ttran244-uic/Senior-Design-2025-Intercom/ECE 397 Ordering Form_02-03-25.xlsx

Team Name: Hertz So Good (H.S.G.) ~ Team 16 |  |  |  |  | ECE Project Mentor (Name and Email): | Dr. Ryan Corey, corey1@uic.edu
Team Representative email | mloera3@uic.edu |  |  |  | ECE 397 Professor (Name and Email): | Dr. Renata Revelo Alonso, revelo@uic.edu
Preferred Delivery date: | 2025-02-07
Name of Part | Part Number | Quantity | Unit Cost | Total Price | Website Link
Audio processor | ADAU1701JSTZ | 2 | 14.68 | 29.36 | https://www.digikey.com/en/products/detail/analog-devices-inc/ADAU1701JSTZ/1246074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
Power Path Controller | LTC4412HVIS6#TRPBFDKR-ND - Digi-Reel® | 1 | 7.11 | 7.11 | https://www.digikey.com/en/products/detail/analog-devices-inc/LTC4412HVIS6-TRPBF/1621436
Antenna w/ transceiver | CC1101 Wireless Module with SMA Antenna Wireless Transceiver Module x2 | 1 | 18.99 | 18.99 | https://www.amazon.com/DWEII-Wireless-Antenna-Transceiver-Arduino/dp/B0CSYX1454
Speaker amplifier | PAM8403 Mini 2 Channel 3W Stereo Class D Audio Power Amplifier Module Board (2-pack) | 1 | 5.49 | 5.49 | https://www.amazon.com/PAM8403-Channel-Amplifier-Envistia-Mall/dp/B07N12VPTS
Battery | BL3000F9031781S1PCNC | 2 | 19.03 | 38.06 | https://www.digikey.com/en/products/detail/globtek-inc/BL3000F9031781S1PCNC/14829887
Charger | Lithium Battery Charger Module Charging | 1 | 5.99 | 5.99 | https://www.amazon.com/HiLetgo-Lithium-Charging-Protection-Functions/dp/B07PKND8KG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
 | USB C Charger Block 2-Pack | 1 | 5.99 | 5.99 | https://www.amazon.com/Charger-2-Pack-Charging-Adapter-Samsung/dp/B0D8JDSYZB?s=electronics
Microphone | 6 Pieces Electret Microphone Amplifier Module MAX4466 | 1 | 9.99 | 9.99 | https://www.amazon.com/Electret-Microphone-Amplifier-Adjustable-Breakout/dp/B08N4FNFTR
Microphone | TA312S | 1 | 25.99 | 25.99 | https://www.amazon.com/Behringer-Dynamic-Microphone-TA-312S/dp/B083FJJPNH
XLR Connector | E3FRA | 1 | 8.23 | 8.23 | https://www.digikey.com/en/products/detail/switchcraft-inc/E3FRA/1289115
Buck/boost converter | LTC1475CS8-3.3#PBF | 2 | 12.82 | 25.64 | https://www.digikey.com/en/products/detail/analog-devices-inc/LTC1475CS8-3.3-PBF/963201?gQT=1
Volume dial | Anodized Aluminum Machined Knob - Black - 20mm Diameter | 4 | 2.95 | 11.8 | https://www.adafruit.com/product/5527
Push-button (blue) | Rugged Metal On/Off Switch with Blue LED Ring - 16mm Blue On/Off | 2 | 4.95 | 9.9 | https://www.adafruit.com/product/915
Push-button (green) | Rugged Metal On/Off Switch with Green LED Ring - 16mm Green On/Off | 2 | 4.95 | 9.9 | https://www.adafruit.com/product/482
Push-button (white) | Rugged Metal On/Off Switch with White LED Ring - 16mm White On/Off | 2 | 4.95 | 9.9 | https://www.adafruit.com/product/917
Push-button (red) | Rugged Metal On/Off Switch with Green LED Ring - 16mm Red On/Off | 2 | 4.95 | 9.9 | https://www.adafruit.com/product/916
USB-C Breakout Board | 1568-1958-ND | 2 | 4.95 | 9.9 | BOB-15100 SparkFun Electronics | Prototyping, Fabrication Products | DigiKey (https://www.digikey.com/en/products/detail/sparkfun-electronics/BOB-15100/9770720)
Boost Converter | 5V-32V Input to 6V-48V Output Adjustable Boost Step Up XL6009 DC-DC Converter | 1 | 6.49 | 6.49 | Amazon.com: 5V-32V Input to 6V-48V Output Adjustable Boost Step Up XL6009 DC-DC Converter : Electronics (https://www.amazon.com/3V-32V-5V-48V-Output-Adjustable-Converter/dp/B01MS3IAVL)
Headphone Jack | 54-00174 | 1 | 0.66 | 0.66 | https://www.digikey.com/en/products/detail/tensility-international-corp/54-00174/12140150
 | Potentiometer - 10k-ohm | 3 | 1.25 | 3.75 | https://www.adafruit.com/product/4133
 |  |  |  | 0
 |  |  |  | 0
 |  |  |  | 0
 |  |  |  | 0
 |  |  |  | 0
 |  |  | total | 253.04
 |  |  |  | 0
 |  |  |  | 0
 |  |  |  | 0
 |  |  |  | 0
 |  |  |  | 0
 |  |  |  | 0
 |  |  |  | 0
 |  |  |  | 0
 |  |  |  | 0
 |  |  |  | 0
 |  |  |  | 0
 |  |  |  | 0
 |  |  |  | 0
 |  |  |  | 0
 |  |  |  | 0
 |  |  |  | 0
 |  |  |  | 0
 |  |  |  | 0
 |  |  |  | 0
 |  |  |  | 0
