ttran244-uic/Senior-Design-2025-Intercom/ECE 397 Ordering Form_02-04-25.xlsx

Team Name: Hertz So Good (H.S.G.) ~ Team 16 |  |  |  |  | ECE Project Mentor (Name and Email): | Dr. Ryan Corey, corey1@uic.edu
Team Representative email | mloera3@uic.edu |  |  |  | ECE 397 Professor (Name and Email): | Dr. Renata Revelo Alonso, revelo@uic.edu
Preferred Delivery date: | 2025-02-10
Name of Part | Part Number | Quantity | Unit Cost | Total Price | Website Link
Antenna w/ transceiver | CC1101 Wireless Module with SMA Antenna Wireless Transceiver Module | 1 | 18.99 | 18.99 | https://www.amazon.com/CC1101-Multi-Frequency-Transceiver-Modules-2PCS/dp/B0DBSYK911
Speaker amplifier | NOYITO PAM8406 Digital Amplifier Board 5W 5W Dual Channel Stereo Audio Module (2 pack) | 1 | 5.99 | 5.99 | https://www.amazon.com/NOYITO-PAM8406-Digital-Amplifier-Dual-Channel/dp/B07FZYK7HG
 |  |  |  | 0
 |  |  |  | 0
 |  |  | 24.98 | 0
 |  |  |  | 0
 |  |  |  | 0
 |  |  |  | 0
 |  |  |  | 0
 |  |  |  | 0
 |  |  |  | 0
 |  |  |  | 0
 |  |  |  | 0
 |  |  |  | 0
 |  |  |  | 0
 |  |  |  | 0
 |  |  |  | 0
 |  |  |  | 0
 |  |  |  | 0
 |  |  |  | 0
 |  |  |  | 0
 |  |  |  | 0
 |  |  |  | 0
 |  |  |  | 0
 |  |  |  | 0
 |  |  |  | 0
 |  |  |  | 0
 |  |  |  | 0
