ttran244-uic/Senior-Design-2025-Intercom/ECE 397 Ordering Form_02-18-25.xlsx

Team Name: Hertz So Good (H.S.G.) ~ Team 16 |  |  |  |  | ECE Project Mentor (Name and Email): | Dr. Ryan Corey, corey1@uic.edu
Team Representative email | nlara6@uic.edu |  |  |  | ECE 397 Professor (Name and Email): | Dr. Renata Revelo Alonso, revelo@uic.edu
Preferred Delivery date: | 2025-02-24
Name of Part | Part Number | Quantity | Unit Cost | Total Price | Website Link
3.5mm Headphone Jack with Switch | SJ-43515RS-SMT-TR | 2 | 0.93 | 1.86 | https://www.digikey.com/en/products/detail/same-sky-formerly-cui-devices/SJ-43515RS-SMT-TR/669722
Stereo Audio Amplifier | PAM8406DR | 2 | 1.34 | 2.68 | https://www.digikey.com/en/products/detail/diodes-incorporated/PAM8406DR/4033289
Ferrite Beads | MPZ1608S221ATA00 | 10 | 0.1 | 1 | https://www.digikey.com/en/products/detail/tdk-corporation/MPZ1608S221ATA00/571872
Headphone Amplifier | MAX97220 | 1 | 3.15 | 3.15 | https://www.digikey.com/en/products/detail/analog-devices-inc-maxim-integrated/MAX97220AETE-T/2744332
