ttran244-uic/Senior-Design-2025-Intercom/ECE 397 Ordering Form_02-25-25 (Dr. Corey).xlsx

Team Name: Hertz So Good (H.S.G.) ~ Team 16 |  |  |  |  | ECE Project Mentor (Name and Email): | Dr. Ryan Corey, corey1@uic.edu
Team Representative email | nlara6@uic.edu |  |  |  | ECE 397 Professor (Name and Email): | Dr. Renata Revelo Alonso, revelo@uic.edu
Preferred Delivery date: | 2025-02-28
Name of Part | Part Number | Quantity | Unit Cost | Total Price | Website Link
Arduino Nano ESP32 | Arduino Nano ESP32 with headers [ABX00083] ESP32-S3, USB-C, Wi-Fi, Bluetooth, HID Support, MicroPython Compatible | 1 | $23.00 | $23.00 | Amazon Link (https://www.amazon.com/Arduino-ABX00083-Bluetooth-MicroPython-Compatible/dp/B0C947BHK5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)
USB-C to USB-C Data Cables | 1FT USB C to USB C Cable 100W 2 Packs, Short USB C 3.1 Fast Charging PD Cord, 10Gbps High Speed Data, 4K@60Hz Video Output Compatible for iPhone 15/15 Plus/15 Pro Max, MacBook, Monitor, SSD | 1 | $8.99 | $8.99 | Amazon Link (https://www.amazon.com/SUMPK-Charging-MacBook-Samsung-Display/dp/B09Z6J21LY?sp_csd=d2lkZ2V0TmFtZT1zcF9hdGY)
EEPROM | 24AA256-I/ST | 2 | $1.09 | $2.18 | DigiKey Link (https://www.digikey.com/en/products/detail/microchip-technology/24AA256-I-ST/442755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)
Transceiver | HiLetgo 2pcs NRF24L01+PA+LNA Wireless Transceiver RF Transceiver Module with SMA Antenna 2.4G 1100m | 1 | $8.49 | $8.49 | Amazon Link (https://www.amazon.com/HiLetgo%C2%AE-NRF24L01-Wireless-Transceiver-Compatible/dp/B00WG9HO6Q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)
