ttran244-uic/Senior-Design-2025-Intercom/CAD Files/ECE 397_Secondary Casing.stl

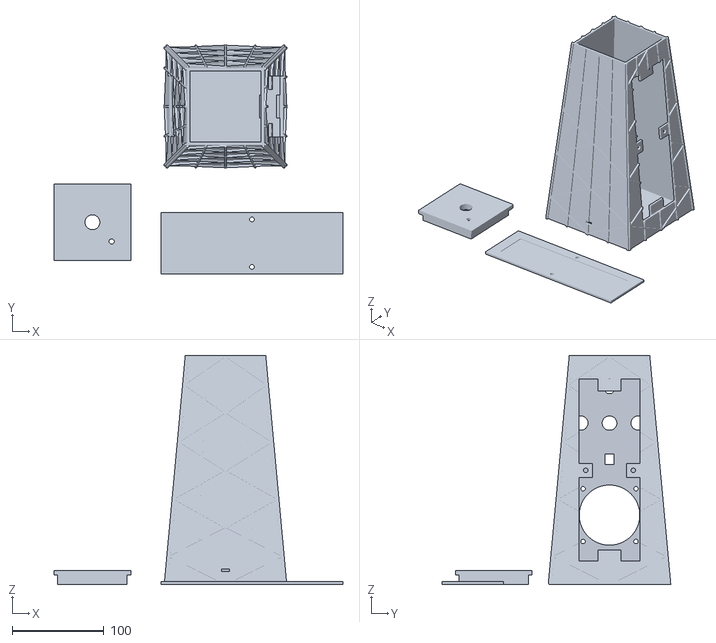
[picture p1: CAD file, 2025-06-10]
CAD Files/ECE 397_Secondary Casing.stl
315.9 x 249.9 x 250.4
