ttran244-uic/Senior-Design-2025-Intercom/CAD Files/ECE 397_Primary Casing (Lid).stl

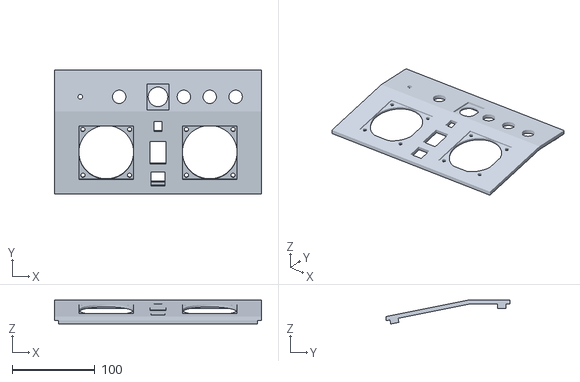
[picture p2: CAD file, 2025-06-10]
CAD Files/ECE 397_Primary Casing (Lid).stl
250.0 x 150.0 x 28.9
