ttran244-uic/Senior-Design-2025-Intercom/Schematics/Primary Audio Amplifier Module.pdf

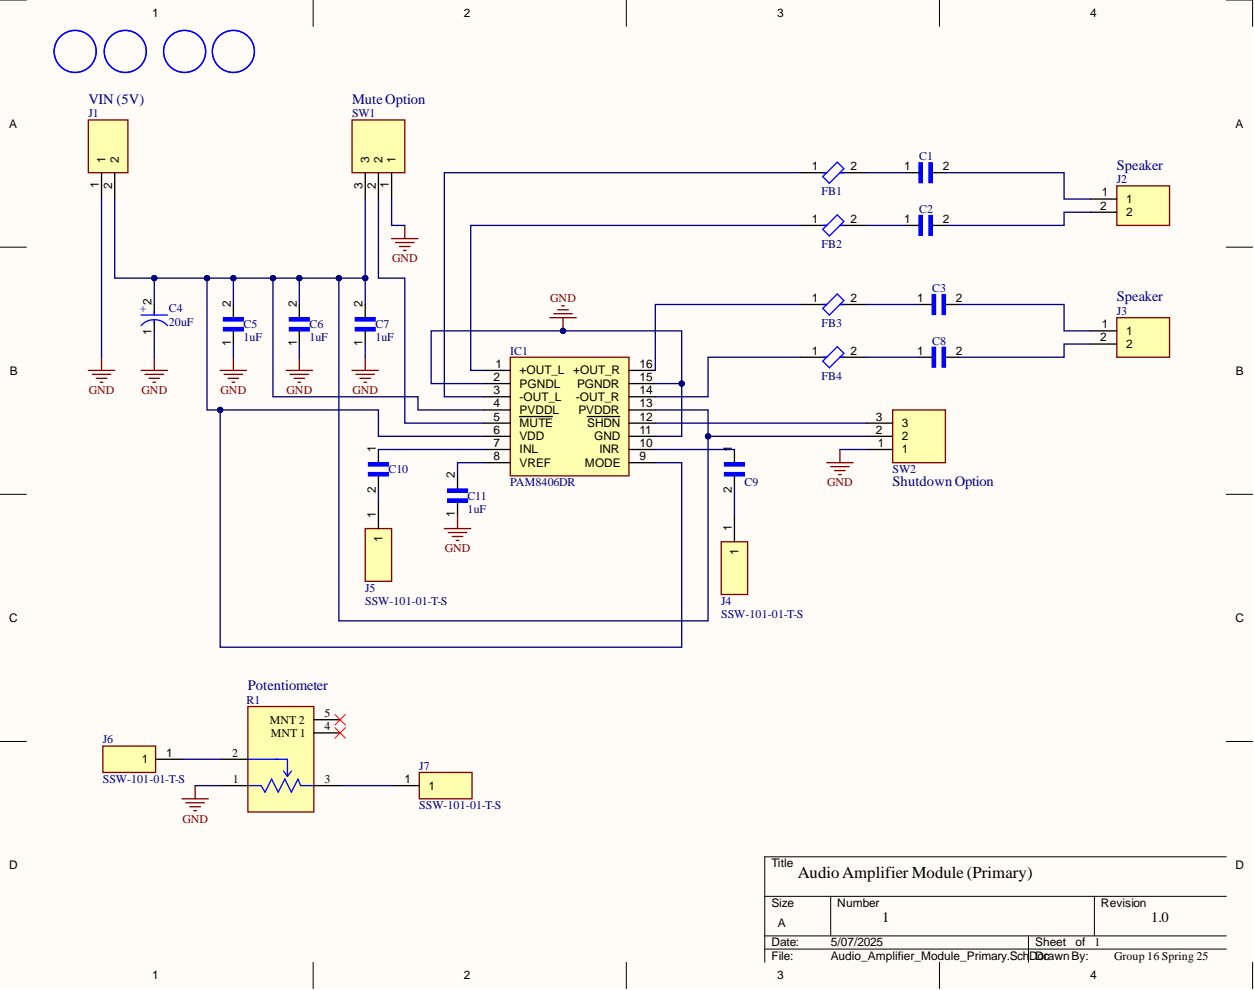
[picture p4: page 1]

GND

PGNDL 2 PGNDR -OUT_R | 15
-OUT_L 3 | 14
PVDDL 4 PVDDR | 13
MUTE 5 SHDN INR | 12

INL 7 | 10

Title
Audio Amplifier Module (Primary)
