ttran244-uic/Senior-Design-2025-Intercom/Schematics/Primary Device Schematic.pdf

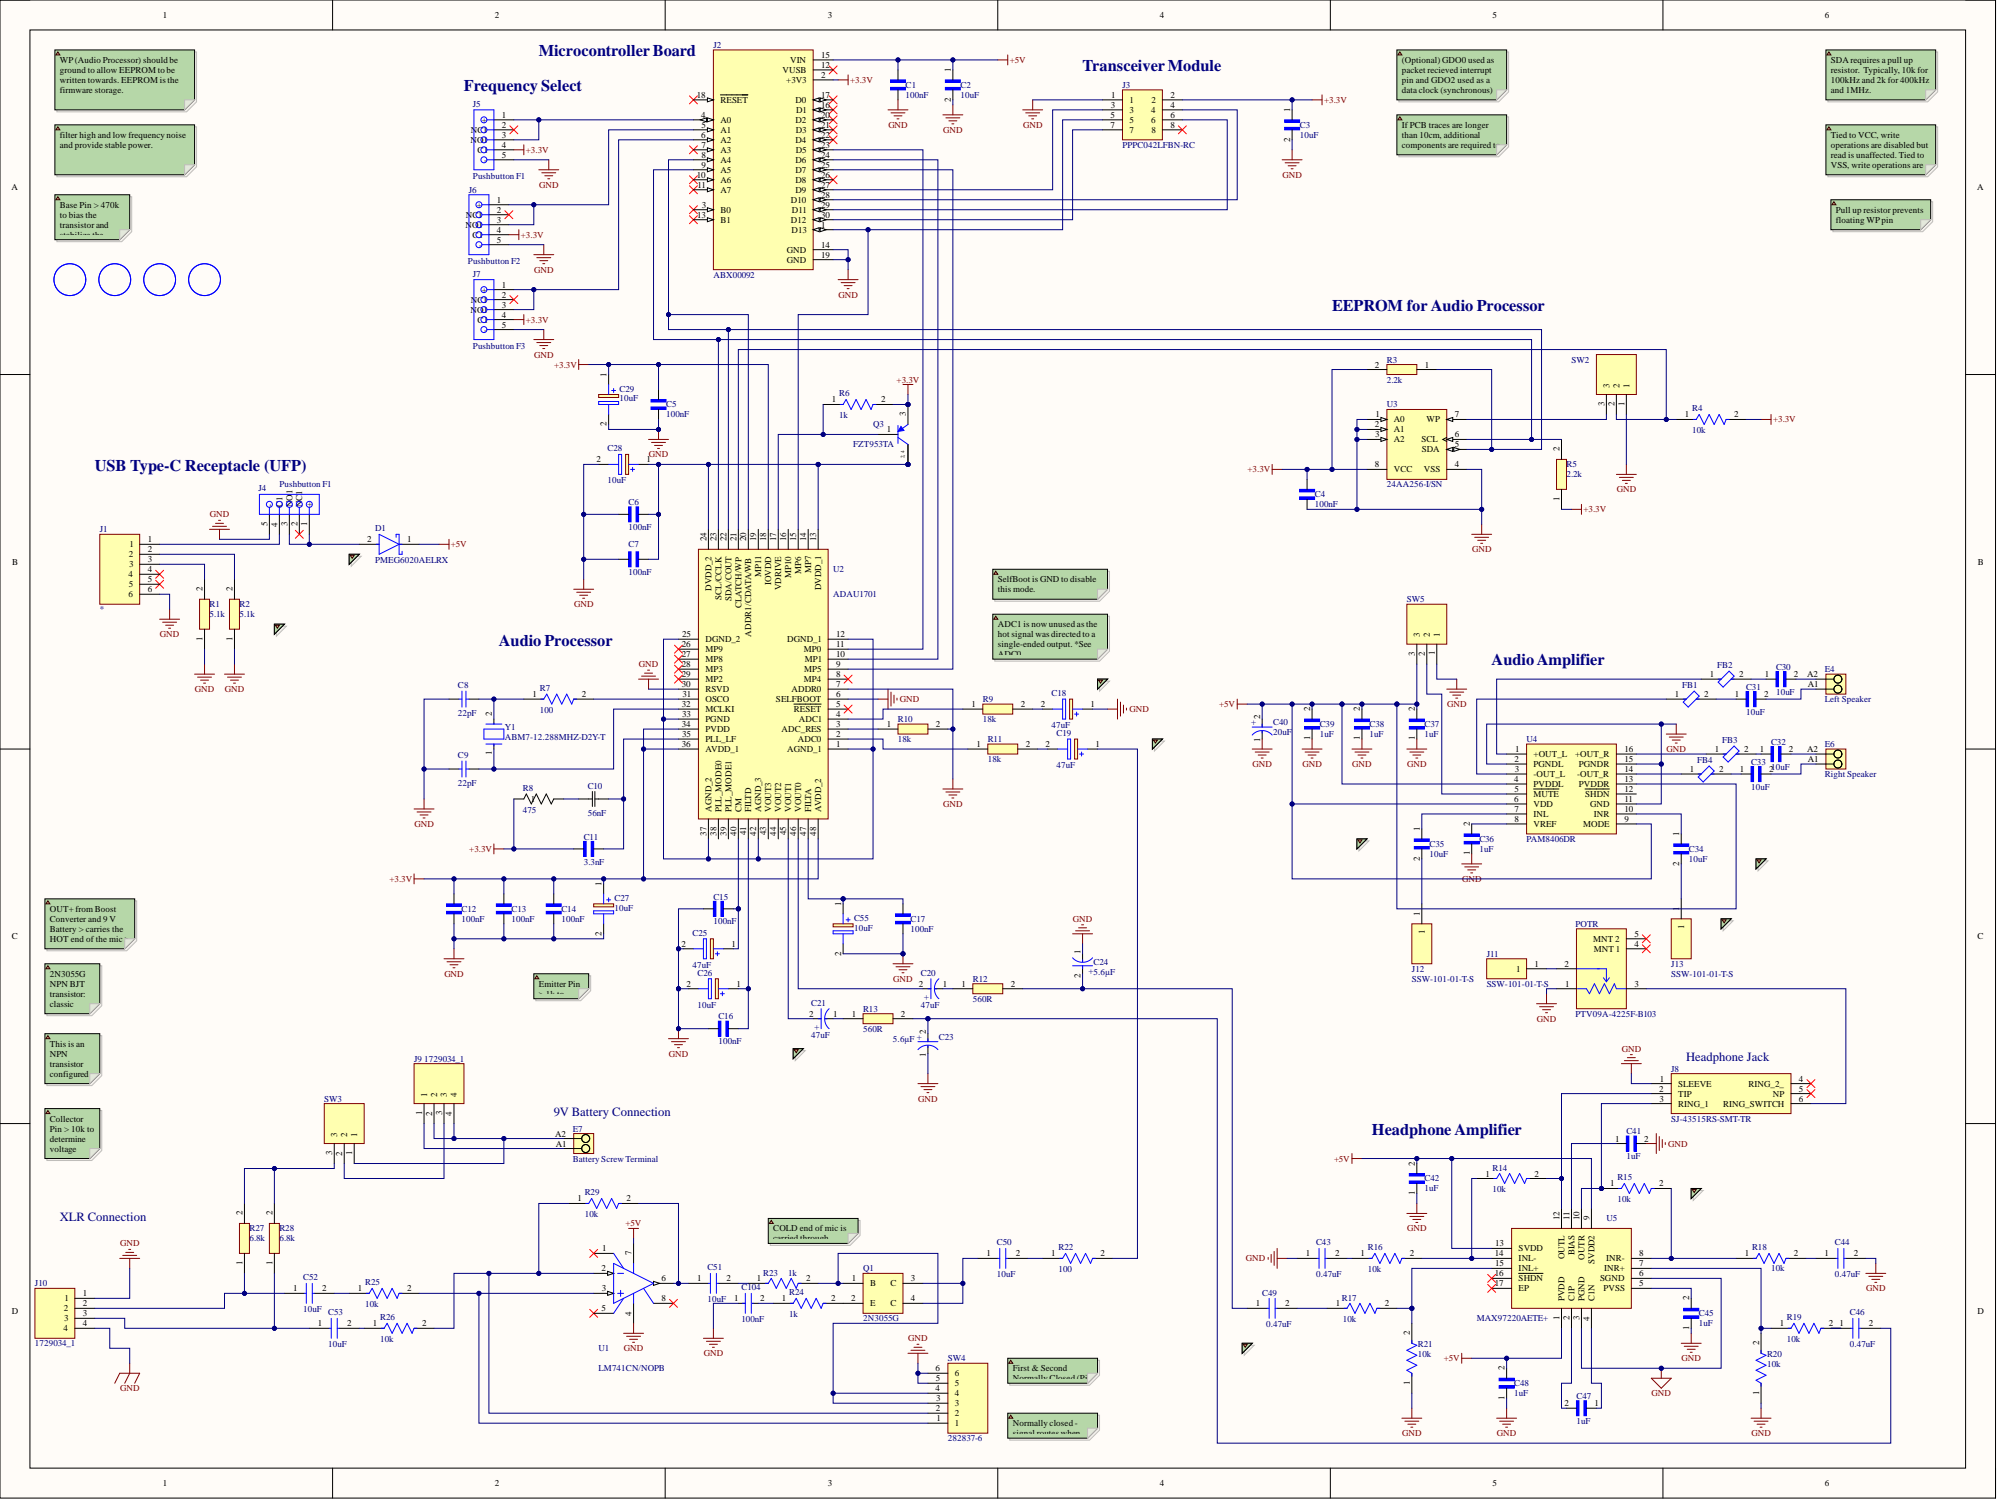
[picture p5: page 1]

WP (Audio Processor) should be
ground to allow EEPROM to be
written towards. EEPROM is the
firmware storage.

(Optional) GDO0 used as
packet recieved interrupt
pin and GDO2 used as a
data clock (synchronous)

SDA requires a pull up
resistor. Typically, 10k for
100kHz and 2k for 400kHz
and 1MHz.

If PCB traces are longer
than 10cm, additional
components are required to

filter high and low frequency noise
and provide stable power.

Tied to VCC, write
operations are disabled but
read is unaffected. Tied to
VSS, write operations are

Pull up resistor prevents
floating WP pin

EEPROM for Audio Processor

USB Type-C Receptacle (UFP)

DVDD_1 13 MP7 14 MP6 15 MP10 16 VDRIVE 17 IOVDD 18 MP11 19 ADDR1/CDATA/WB 20 CLATCH/WP 21 SDA/COUT 22 SCL/CCLK 23 DVDD_2 24 AVDD_1 36 PLL_LF 35 PVDD 34 PGND 33 MCLKI 32 OSCO 31 RSVD 30 MP2 29 MP3 28 MP8 27 MP9 26 DGND_2 25

SelfBoot is GND to disable
this mode.

ADC1 is now unused as the
hot signal was directed to a
single-ended output. *See
ADC0

-OUT_L 3 -OUT_R | 14
PVDDL 4 PVDDR | 13

OUT+ from Boost
Converter and 9 V
Battery > carries the
HOT end of the mic >

COLD end of mic is
carried through
