ttran244-uic/Senior-Design-2025-Intercom/Schematics/Audio Processor Module Schematic.pdf

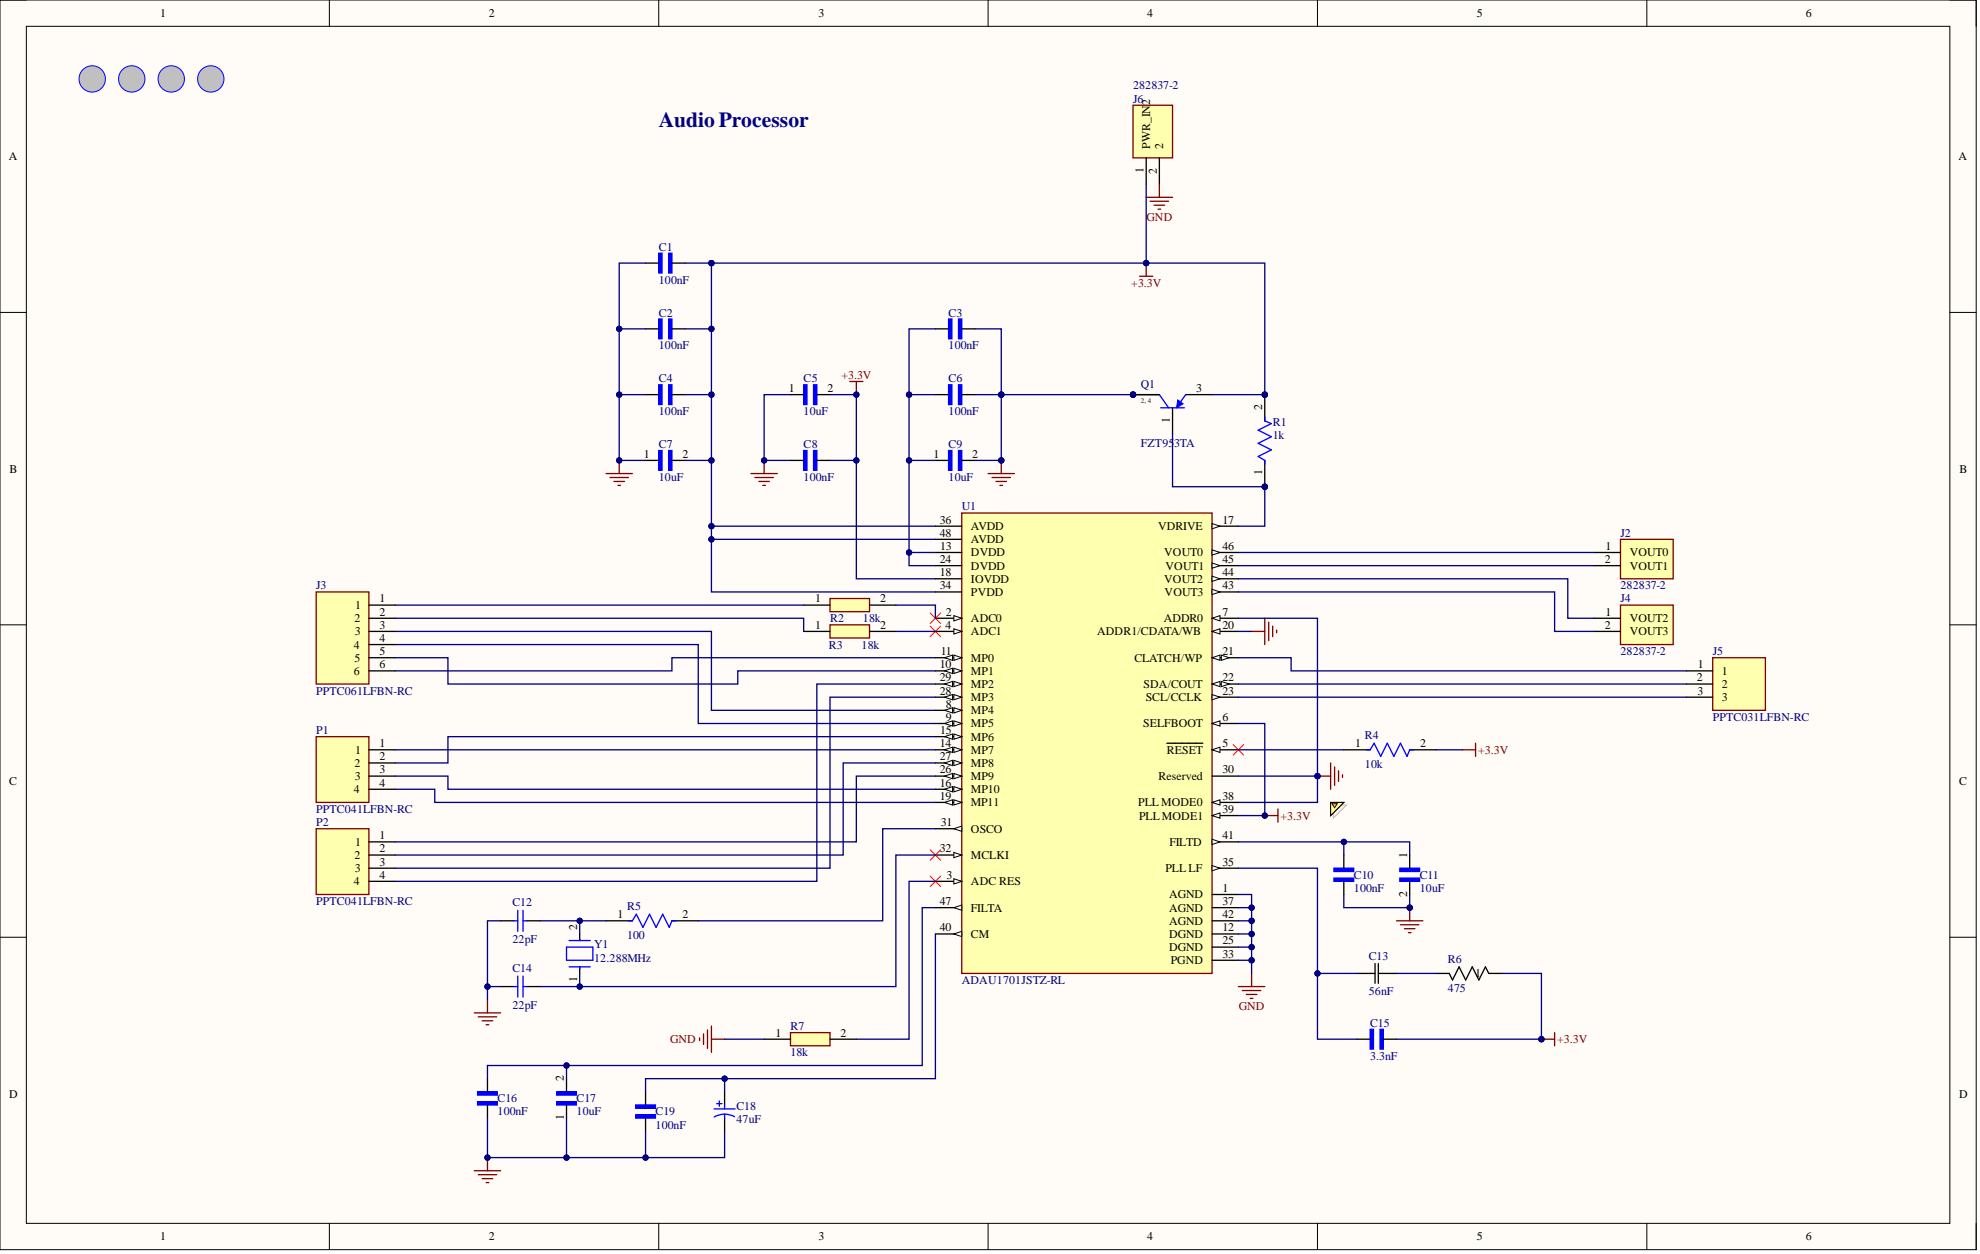
[picture p6: page 1]

AVDD 48

DVDD 24 | VOUT1 2

MP1 10 | 1 1
MP2 29 | 2 2
MP3 28 | 3 3
MP4 8
MP5 9
MP6 15
