ttran244-uic/Senior-Design-2025-Intercom/Schematics/EEPROM Module Schematic.pdf

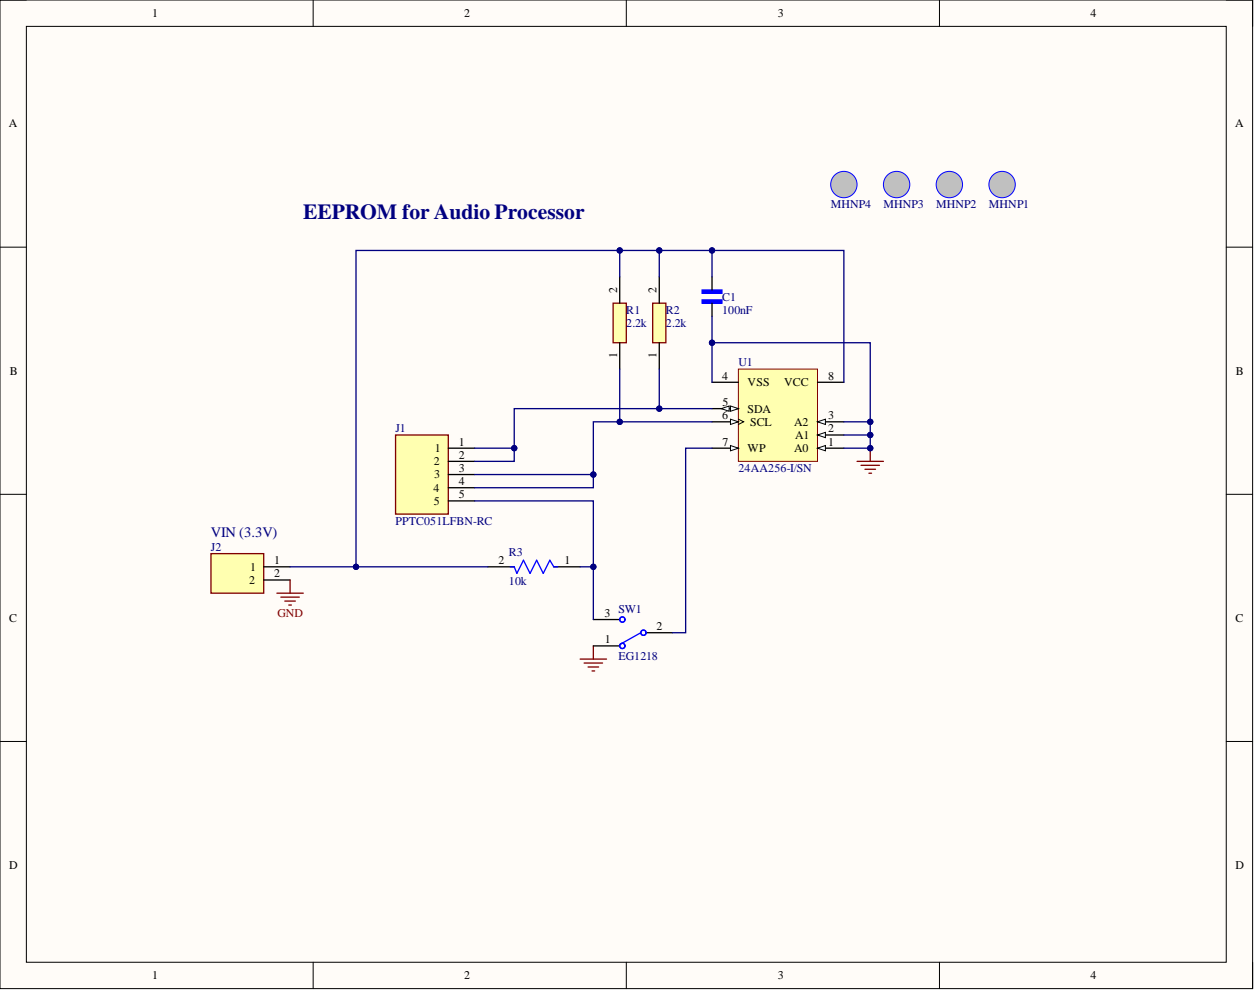
[picture p7: page 1]

EEPROM for Audio Processor
