ttran244-uic/Senior-Design-2025-Intercom/Schematics/Gooseneck Microphone Module.pdf

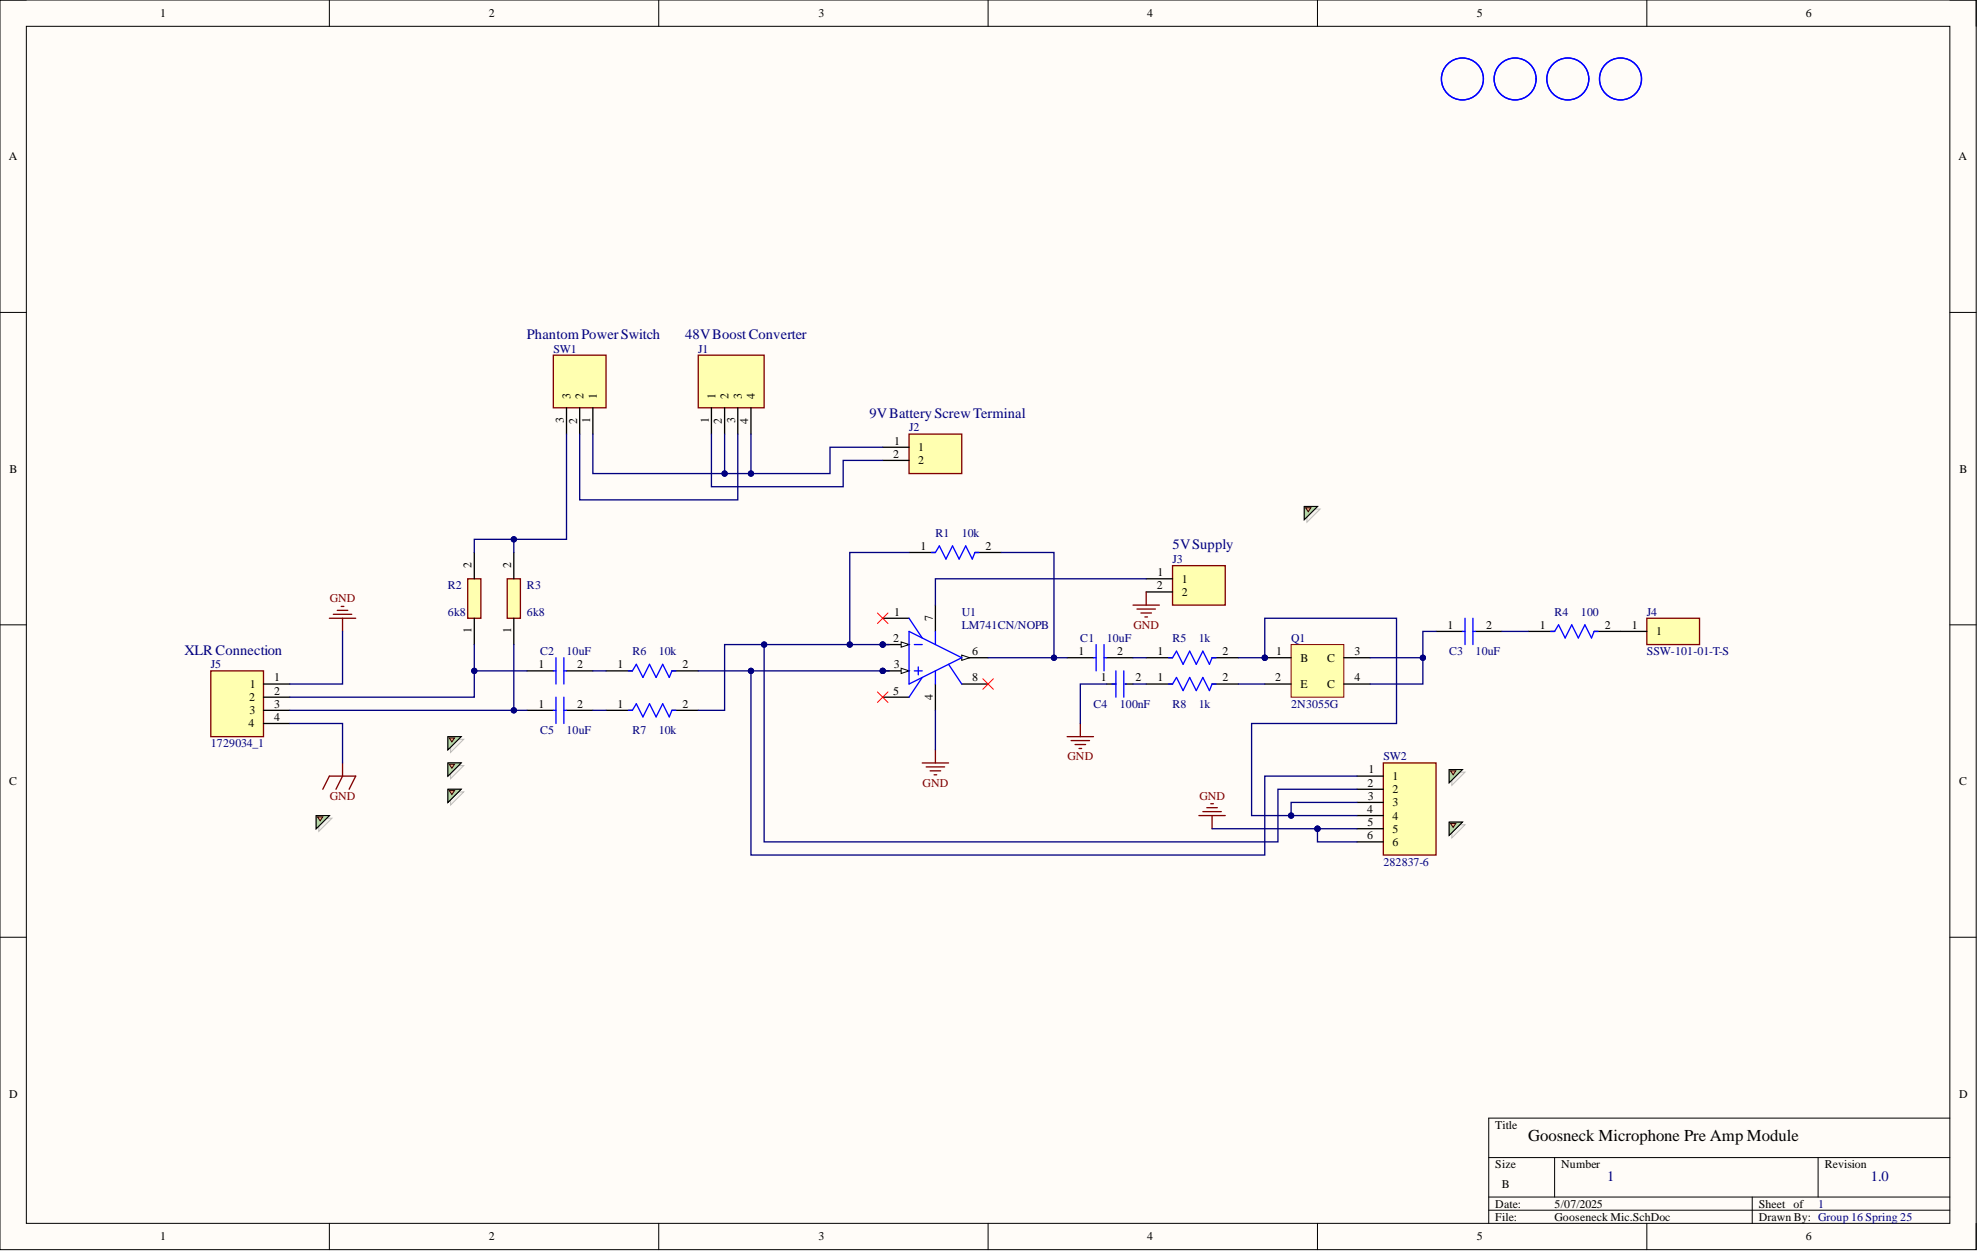
[picture p8: page 1]

Title
Goosneck Microphone Pre Amp Module
