ttran244-uic/Senior-Design-2025-Intercom/Schematics/Headphone Amplifier Module.pdf

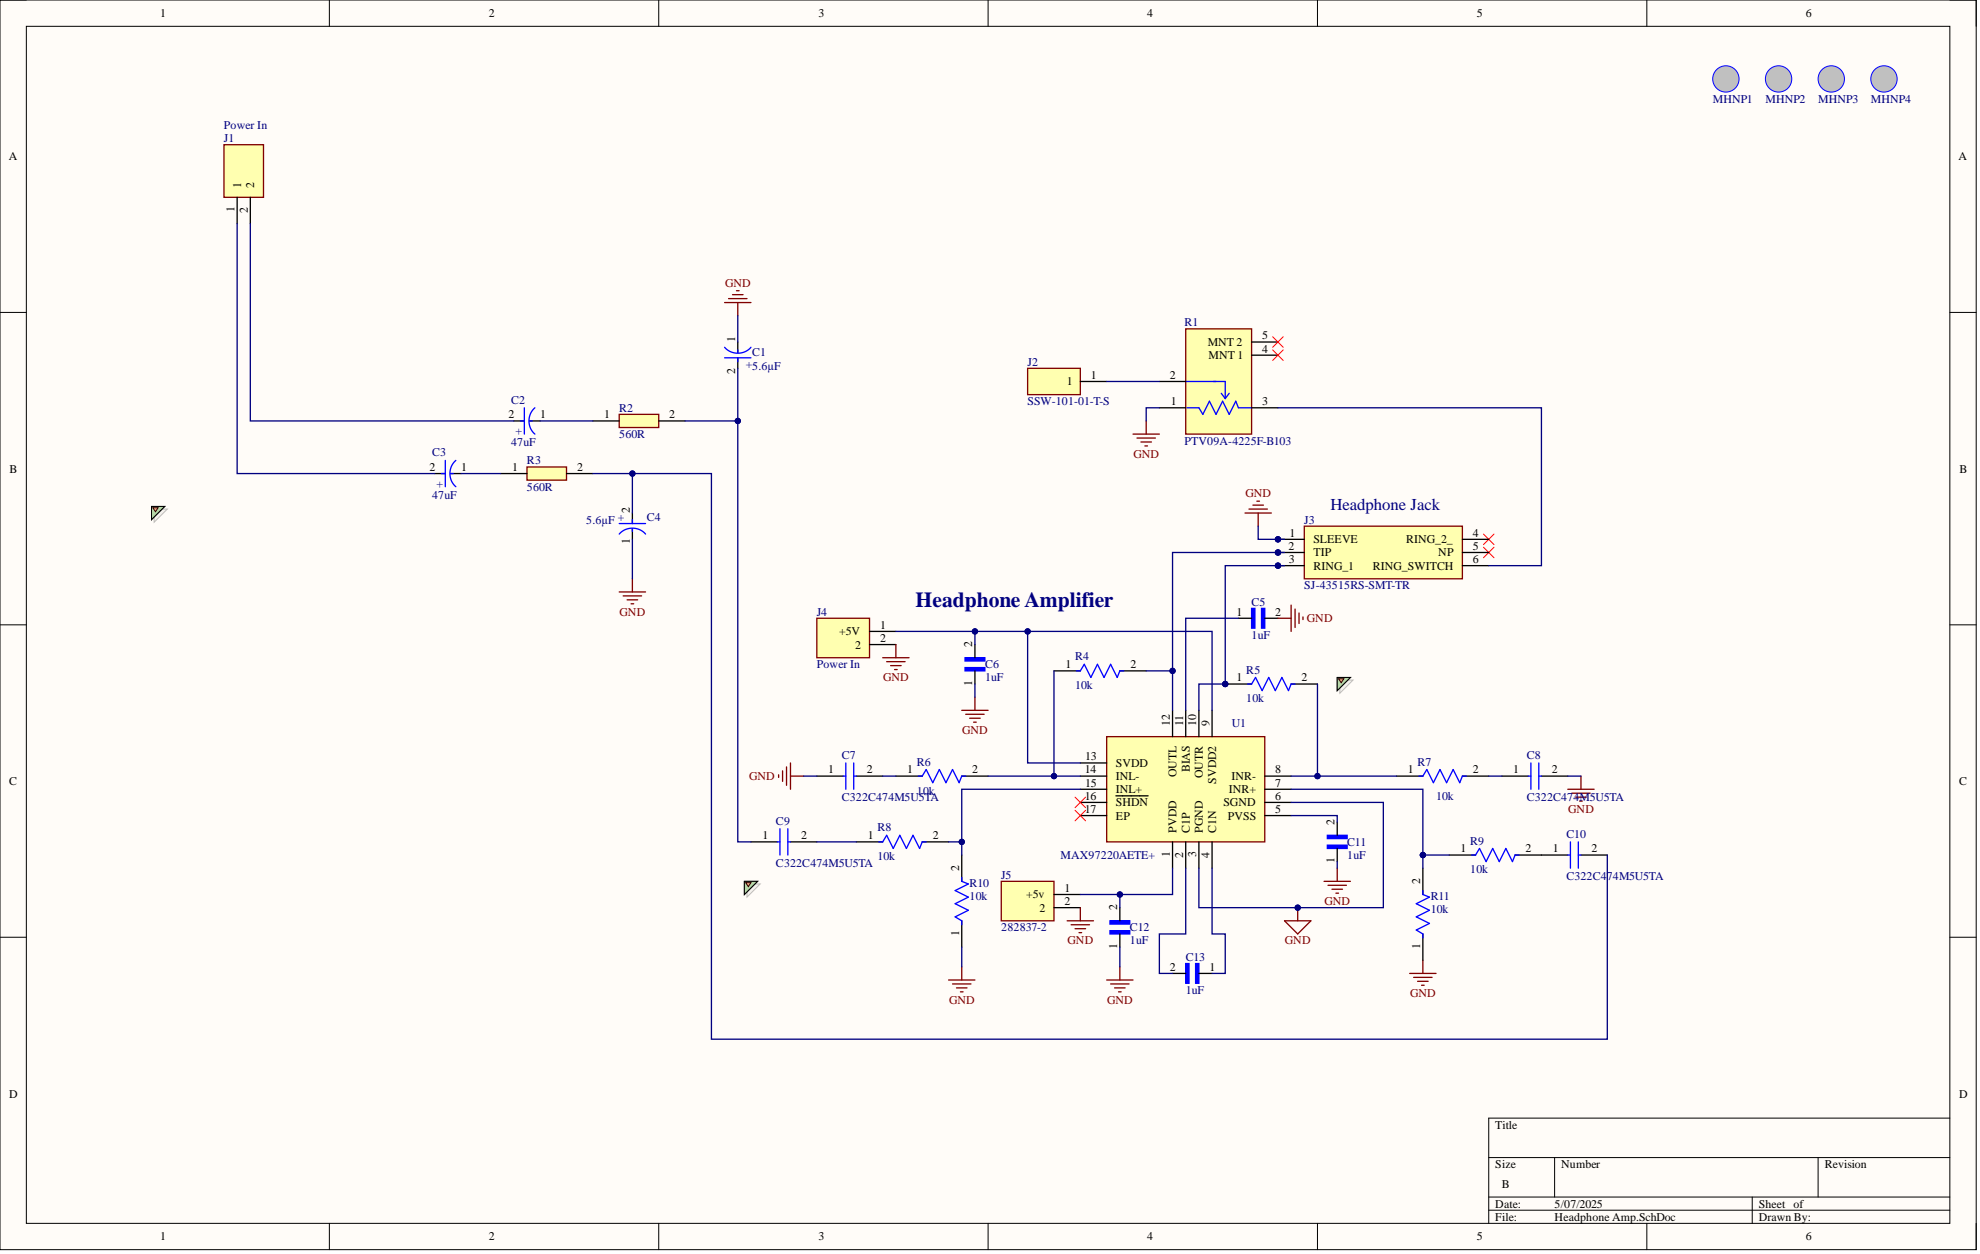
[picture p9: page 1]
