ttran244-uic/Senior-Design-2025-Intercom/Schematics/Secondary Audio Amplifier Module Schematic.pdf

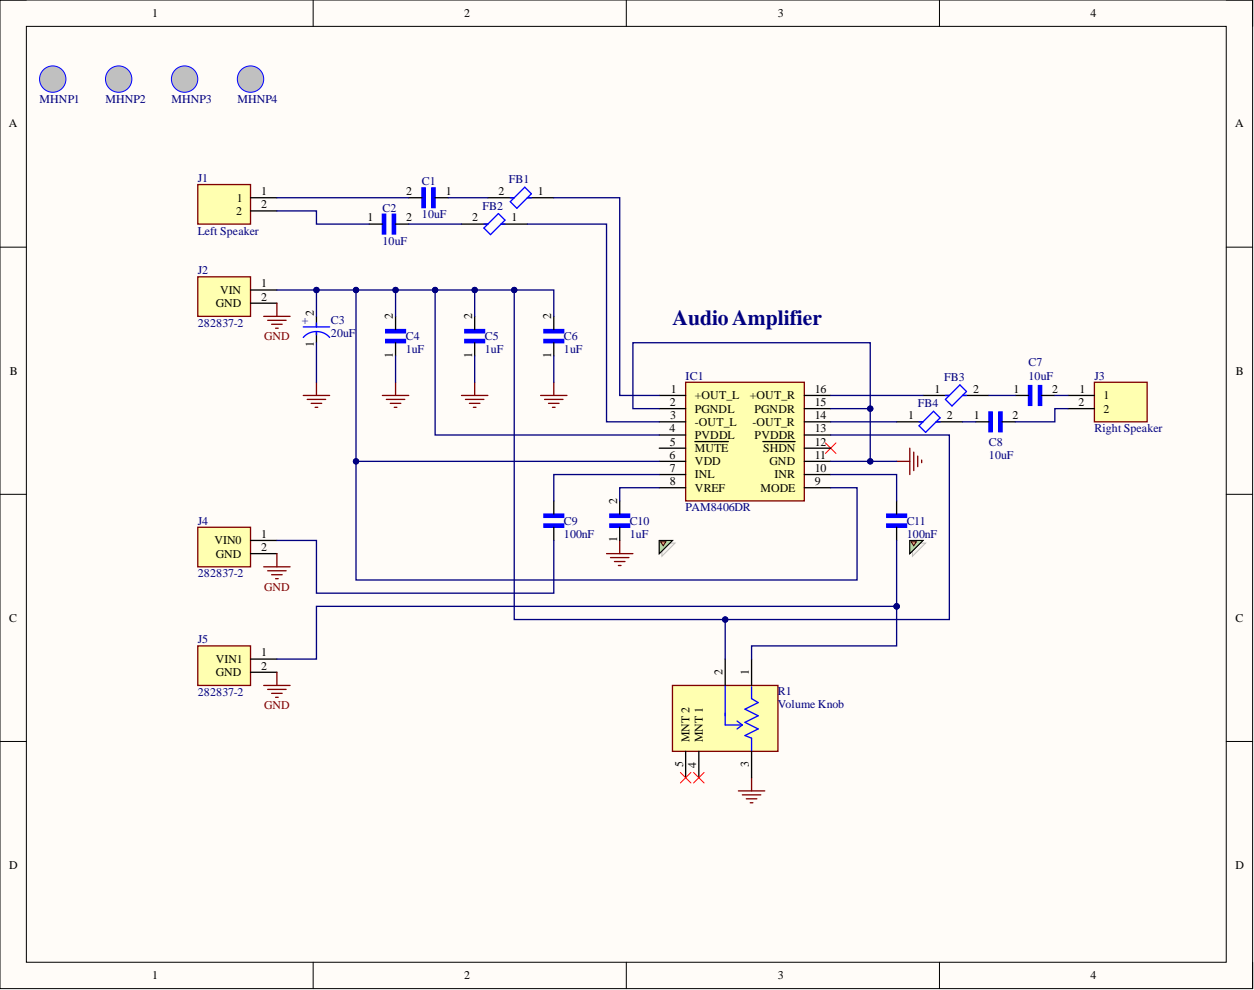
[picture p10: page 1]
