ttran244-uic/Senior-Design-2025-Intercom/Schematics/Secondary Device Schematic.pdf

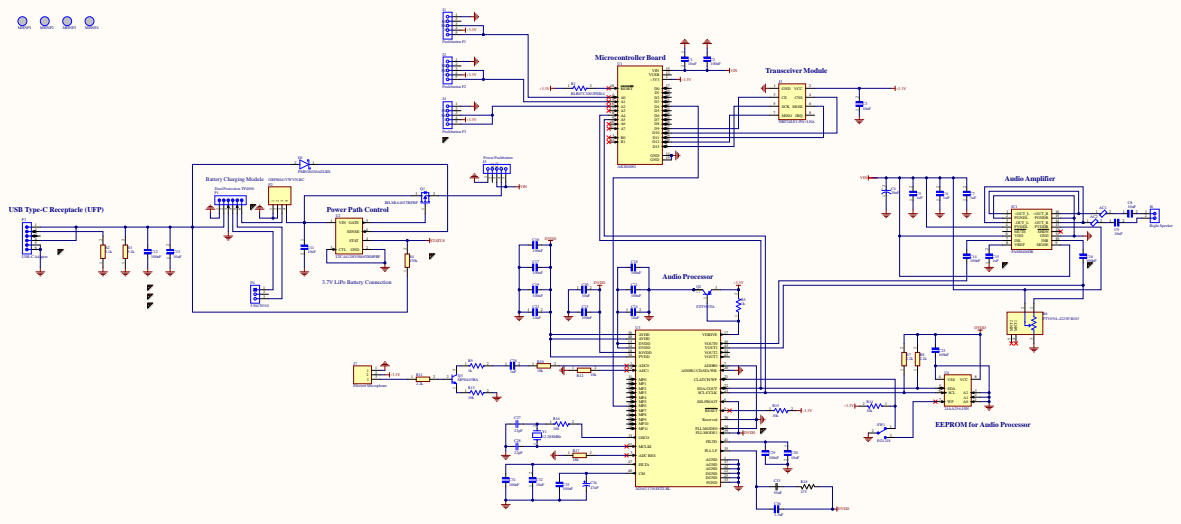
[picture p11: page 1]

IRLML 6 4 0 2 TRPB o l | F

2 | IC1 PAM8 PG N D L PG N D R -O U T _L -O U T_R PV D D L PV D D R MU T E SH D N V D D G N D IN L IN R VRE F MO D E | 1 5

7 | 1 0

4 8 | | 4 6
1 3
2 4 | | 4 5
1 8 | | 4 4 | | | | C2 5 1 0 0 n F
3 4 | 4 3

3 7

1 2
2 5
3 3
